ese5160/a14g-final-submission-s25-t27-pocket-pet/image/README/1746238575769.png

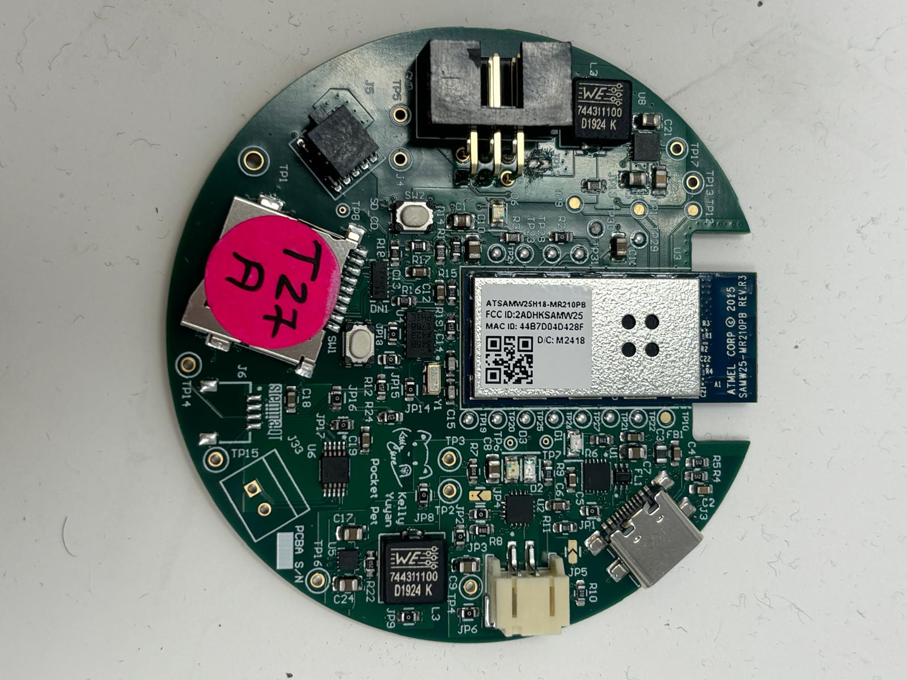
image/README/1746238575769.png
