ese5160/a14g-final-submission-s25-t27-pocket-pet/image/README/1746239008500.png

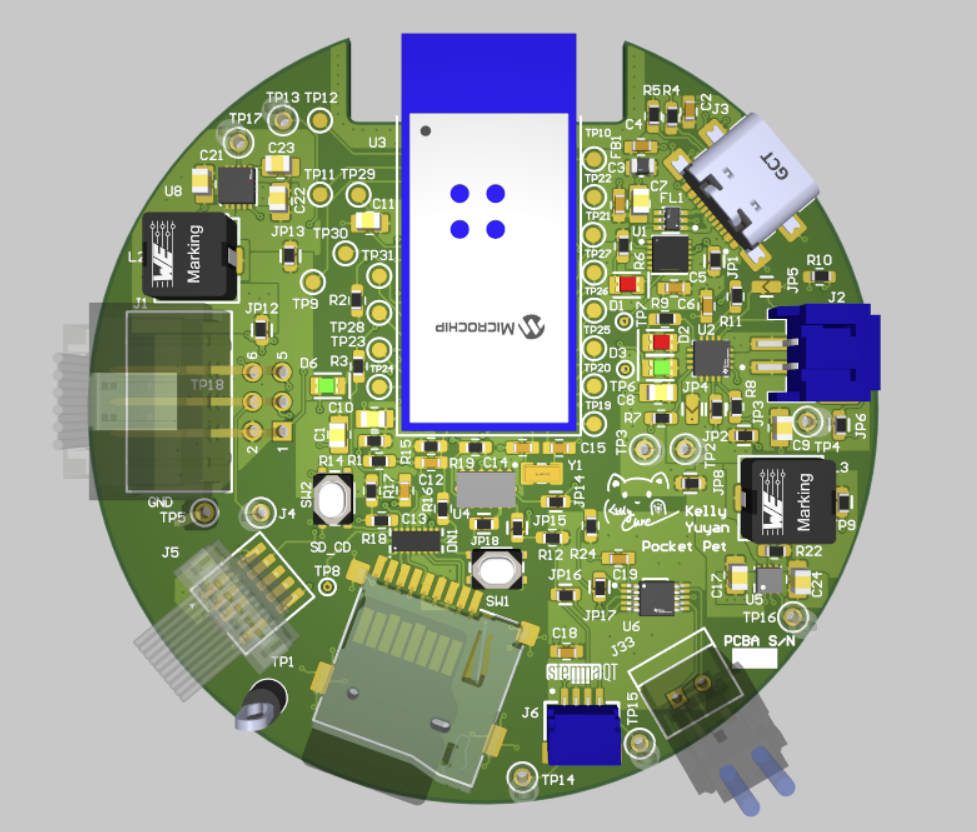
image/README/1746239008500.png
