ese5160/a14g-final-submission-s25-t27-pocket-pet/image/README/1746241287873.jpg

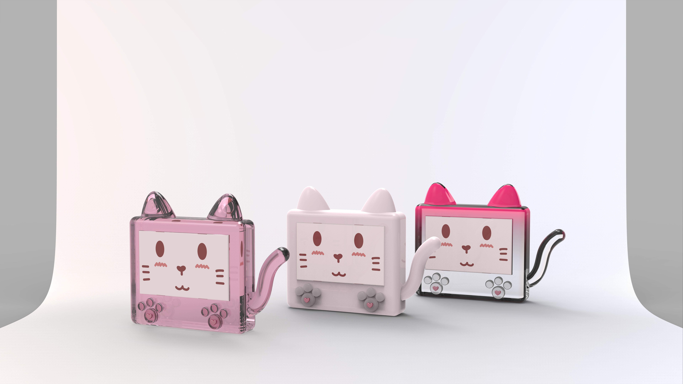
image/README/1746241287873.jpg
